rtsys2020/propendous/PROpendous/PROpendous_Layout.jpg

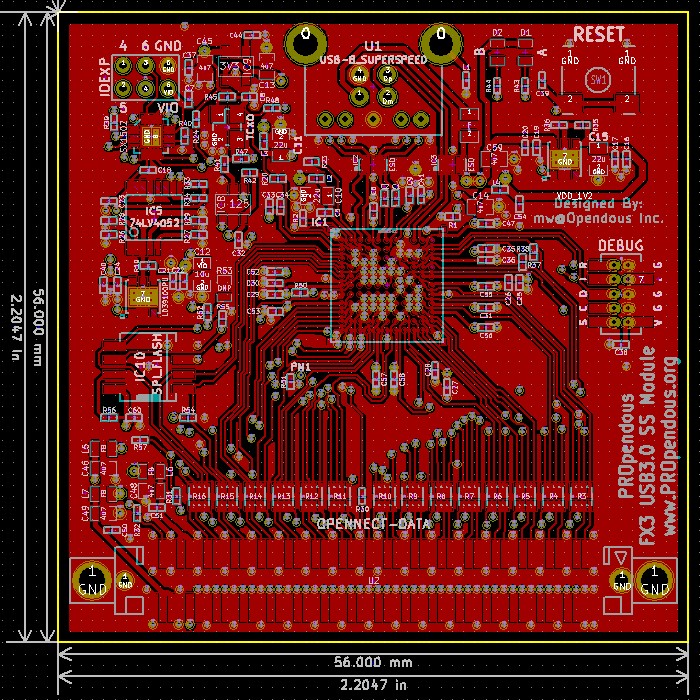
PROpendous/PROpendous_Layout.jpg
