rtsys2020/propendous/PROpendous/PROpendous-GERBERS/readme.txt

File Format: Gerber RS-274-X
Plot Origin: Absolute

	PROpendous-F_Paste.gtp		: Top/Front Layer Solder Paste

	PROpendous-F_SilkS.gto		: Top/Front Layer White Silkscreen
	PROpendous-F_Mask.gts		: Top/Front Layer Green Solder Mask
	PROpendous-F_Cu.gtl		: Top/Front Copper Layer
	PROpendous-Inner1_Cu.gbr	: Inner Copper Layer 1
	PROpendous-Inner2_Cu.gbr	: Inner Copper Layer 2
	PROpendous-B_Cu.gbl		: Bottom/Back Copper Layer
	PROpendous-B_Mask.gbs		: Bottom/Back Layer Green Solder Mask

	PROpendous-Edge_Cuts.gbr	: PCB Edge Outline

Drill File: RC_Audio.drl
	Excellon
	Units: Inches
	M.N (Precision) -> 2.4
	Mode (Drill Origin) : Absolute
	Zero Supression : Suppress Leading Zeros
	Type : ASCII
	Drill Holes (Pads and Vias): 472
	Notes:	- No axis mirroring
		- Standard Vias Only
		- All holes are plated
