rtsys2020/propendous/PROpendous/PROpendous.kicad_pcb

## KiCad design PROpendous/PROpendous.kicad_pcb (2013-10-24)

Schematic: PROpendous.sch, PROpendous FX3 Communication Board

Parts:
C46, C48, C49: 4u7
C50, C51: 0u1
IC1: CYUSB30XX-BZX
L5, L6, L7: FB
P2: PM1
R3, R4, R5, R6, R7, R8, R9, R10, R11, R12, R13, R14, R15, R16, R30, R31, R32: 22
R37, R38: 2.2k
R50, R51, R57: 10k
U2: OPENNECT-DATA

Connections:
26MHz: R32.2 (B); also elsewhere on the board
+3.3V: IC1.B6, L5.2 (B); also elsewhere on the board
+3.3V_BTB: C46.1 (A), L5.1 (A), U2.55 (3.3V)
/26MHz_BTB: R32.1 (A), U2.49 (26MHz)
/System/Dm: IC1.A10; also elsewhere on the board
/System/Dp: IC1.A9; also elsewhere on the board
/System/SSRXm: IC1.A3; also elsewhere on the board
/System/SSRXp: IC1.A4; also elsewhere on the board
/System/SSTXm: IC1.A6; also elsewhere on the board
/System/SSTXp: IC1.A5; also elsewhere on the board
AVDD: IC1.A7; also elsewhere on the board
CLKIN: IC1.D7; also elsewhere on the board
FSLC0: IC1.B2; also elsewhere on the board
FSLC1: IC1.B4; also elsewhere on the board
FSLC2: IC1.E6; also elsewhere on the board
GND: C46.2 (B), C48.2 (B), C49.2 (B), C50.2 (B), C51.2 (B), IC1.A1, IC1.A8, IC1.B7, IC1.B8, IC1.B9, IC1.D8, IC1.E2, IC1.G1, IC1.G11, IC1.K3, IC1.K4, IC1.L1, IC1.L2, IC1.L3, IC1.L6, IC1.L11, R51.1 (A), R57.1 (A), U2.1 (GND), U2.4 (GND), U2.7 (GND), U2.10 (GND), U2.13 (GND), U2.16 (GND), U2.19 (GND), U2.22 (GND), U2.25 (GND), U2.27 (GND), U2.30 (GND), U2.33 (GND), U2.36 (GND), U2.39 (GND), U2.42 (GND), U2.45 (GND), U2.48 (GND), U2.50 (GND), U2.51 (GND), U2.54 (GND), U2.57 (GND), U2.60 (GND), U2.63 (GND), U2.66 (GND), U2.69 (GND), U2.72 (GND), U2.75 (GND), U2.78 (GND), U2.81 (GND), U2.84 (GND), U2.87 (GND), U2.90 (GND), U2.93 (GND), U2.96 (GND), U2.99 (GND), U2.100 (GND); also elsewhere on the board
GPIO00: IC1.F10, R3.1
GPIO00-DQ00: R3.2, U2.2 (GPIO00-DQ00)
GPIO01: IC1.F9, R3.3
GPIO01-DQ01: R3.4, U2.3 (GPIO01-DQ01)
GPIO02: IC1.F7, R3.5
GPIO02-DQ02: R3.6, U2.98 (GPIO02-DQ02)
GPIO03: IC1.G10, R3.7
GPIO03-DQ03: R3.8, U2.97 (GPIO03-DQ03)
GPIO04: IC1.G9, R4.1
GPIO04-DQ04: R4.2, U2.5 (GPIO04-DQ04)
GPIO05: IC1.F8, R4.3
GPIO05-DQ05: R4.4, U2.6 (GPIO05-DQ05)
GPIO06: IC1.H10, R4.5
GPIO06-DQ06: R4.6, U2.95 (GPIO06-DQ06)
GPIO07: IC1.H9, R4.7
GPIO07-DQ07: R4.8, U2.94 (GPIO07-DQ07)
GPIO08: IC1.J10, R5.1
GPIO08-DQ08: R5.2, U2.8 (GPIO08-DQ08)
GPIO09: IC1.J9, R5.3
GPIO09-DQ09: R5.4, U2.9 (GPIO09-DQ09)
GPIO10: IC1.K11, R5.5
GPIO10-DQ10: R5.6, U2.92 (GPIO10-DQ10)
GPIO11: IC1.L10, R5.7
GPIO11-DQ11: R5.8, U2.91 (GPIO11-DQ11)
GPIO12: IC1.K10, R6.1
GPIO12-DQ12: R6.2, U2.11 (GPIO12-DQ12)
GPIO13: IC1.K9, R6.3
GPIO13-DQ13: R6.4, U2.12 (GPIO13-DQ13)
GPIO14: IC1.J8, R6.5
GPIO14-DQ14: R6.6, U2.89 (GPIO14-DQ14)
GPIO15: IC1.G8, R6.7
GPIO15-DQ15: R6.8, U2.88 (GPIO15-DQ15)
GPIO16: IC1.J6, R30.2 (B)
GPIO16-PCLK: R30.1 (A), U2.26 (GPIO16-PCLK)
GPIO17: IC1.K8, R11.1
GPIO17-CTL00: R11.2, U2.74 (GPIO17-CTL00)
GPIO18: IC1.K7, R11.3
GPIO18-CTL01: R11.4, U2.73 (GPIO18-CTL01)
GPIO19: IC1.J7, R11.5
GPIO19-CTL02: R11.6, U2.28 (GPIO19-CTL02)
GPIO20: IC1.H7, R11.7
GPIO20-CTL03: R11.8, U2.29 (GPIO20-CTL03)
GPIO21: IC1.G7, R12.1
GPIO21-CTL04: R12.2, U2.71 (GPIO21-CTL04)
GPIO22: IC1.G6, R12.3
GPIO22-CTL05: R12.4, U2.70 (GPIO22-CTL05)
GPIO23: IC1.K6, R12.5
GPIO23-CTL06: R12.6, U2.31 (GPIO23-CTL06)
GPIO24: IC1.H8, R12.7
GPIO24-CTL07: R12.8, U2.32 (GPIO24-CTL07)
GPIO25: IC1.G5, R13.1
GPIO25-CTL08: R13.2, U2.68 (GPIO25-CTL08)
GPIO26: IC1.H6, R13.3
GPIO26-CTL09: R13.4, U2.67 (GPIO26-CTL09)
GPIO27: IC1.K5, R13.5
GPIO27-CTL10: R13.6, U2.34 (GPIO27-CTL10)
GPIO28: IC1.J5, R13.7
GPIO28-CTL11: R13.8, U2.35 (GPIO28-CTL11)
GPIO29: IC1.H5, R14.1
GPIO29-CTL12: R14.2, U2.65 (GPIO29-CTL12)
GPIO30-PMODE0: IC1.G4, R50.1 (A)
GPIO31-PMODE1: IC1.H4, P2.1
GPIO32-PMODE2: IC1.L4, R51.2 (B)
GPIO33: IC1.K2, R7.1
GPIO33-DQ16: R7.2, U2.14 (GPIO33-DQ16)
GPIO34: IC1.J4, R7.3
GPIO34-DQ17: R7.4, U2.15 (GPIO34-DQ17)
GPIO35: IC1.K1, R7.5
GPIO35-DQ18: R7.6, U2.86 (GPIO35-DQ18)
GPIO36: IC1.J2, R7.7
GPIO36-DQ19: R7.8, U2.85 (GPIO36-DQ19)
GPIO37: IC1.J3, R8.1
GPIO37-DQ20: R8.2, U2.17 (GPIO37-DQ20)
GPIO38: IC1.J1, R8.3
GPIO38-DQ21: R8.4, U2.18 (GPIO38-DQ21)
GPIO39: IC1.H2, R8.5
GPIO39-DQ22: R8.6, U2.83 (GPIO39-DQ22)
GPIO40: IC1.H3, R8.7
GPIO40-DQ23: R8.8, U2.82 (GPIO40-DQ23)
GPIO41: IC1.F4, R9.1
GPIO41-DQ24: R9.2, U2.20 (GPIO41-DQ24)
GPIO42: IC1.G2, R9.3
GPIO42-DQ25: R9.4, U2.21 (GPIO42-DQ25)
GPIO43: IC1.G3, R9.5
GPIO43-DQ26: R9.6, U2.80 (GPIO43-DQ26)
GPIO44: IC1.F3, R9.7
GPIO44-DQ27: R9.8, U2.79 (GPIO44-DQ27)
GPIO45: IC1.F2, R31.2 (B), R57.2 (B)
GPIO45_BTB: R31.1 (A), U2.56 (GPIO45-nRESET)
GPIO46: IC1.F5, R10.1
GPIO46-DQ28: R10.2, U2.23 (GPIO46-DQ28)
GPIO47: IC1.E1, R10.3
GPIO47-DQ29: R10.4, U2.24 (GPIO47-DQ29)
GPIO48: IC1.E5, R10.5
GPIO48-DQ30: R10.6, U2.77 (GPIO48-DQ30)
GPIO49: IC1.E4, R10.7
GPIO49-DQ31: R10.8, U2.76 (GPIO49-DQ31)
GPIO50: IC1.D1, R14.5
GPIO50-I2S_CLK: R14.6, U2.37 (GPIO50-I2S_CLK)
GPIO51: IC1.D2, R14.7
GPIO51-I2S_SD: R14.8, U2.38 (GPIO51-I2S_SD)
GPIO52: IC1.D3, R15.1
GPIO52-I2S_WS: R15.2, U2.62 (GPIO52-I2S_WS)
GPIO53: IC1.D4, R15.7; also elsewhere on the board
GPIO53-UART_RTS-SPI_SCK: R15.8, U2.41 (UART_RTS-SPI_SCK)
GPIO54: IC1.C1, R15.5; also elsewhere on the board
GPIO54-UART_CTS-SPI_nSS: R15.6, U2.40 (UART_CTS-SPI_nSS)
GPIO55: IC1.C2, R16.1; also elsewhere on the board
GPIO55-UART_TX-SPI_MISO: R16.2, U2.59 (UART_TX-SPI_MISO)
GPIO56: IC1.D5, R16.3; also elsewhere on the board
GPIO56-UART_RX-SPI_MOSI: R16.4, U2.58 (UART_RX-SPI_MOSI)
GPIO57: IC1.C4, R15.3
GPIO57-I2S_MCLK: R15.4, U2.61 (GPIO57-I2S_MCLK)
GPIO58: IC1.D9, R16.5, R37.1 (A); also elsewhere on the board
GPIO58-I2C_SCL: R16.6, U2.43 (I2C_SCL)
GPIO59: IC1.D10, R16.7, R38.1 (A); also elsewhere on the board
GPIO59-I2C_SDA: R16.8, U2.44 (I2C_SDA)
R_USB2: IC1.C8; also elsewhere on the board
R_USB3: IC1.B3; also elsewhere on the board
TCK: IC1.F6; also elsewhere on the board
TDI: IC1.E7; also elsewhere on the board
TDO: IC1.C10; also elsewhere on the board
TMS: IC1.E8; also elsewhere on the board
U3RXVDDQ: IC1.A2; also elsewhere on the board
U3TXVDDQ: IC1.B5; also elsewhere on the board
VBUS: IC1.E10, IC1.E11, L7.2 (B); also elsewhere on the board
VBUS_BTB: C49.1 (A), C50.1 (A), L7.1 (A), U2.52 (5V), U2.53 (5V)
VDD_1V2: IC1.B10, IC1.C3, IC1.E9, IC1.F11, IC1.H1, IC1.J11, IC1.L5, IC1.L7; also elsewhere on the board
VIO: IC1.B1, IC1.C11, IC1.E3, IC1.F1, IC1.H11, IC1.L9, L6.2 (B), R37.2 (B), R38.2 (B), R50.2 (B); also elsewhere on the board
VIO_BTB: C48.1 (A), C51.1 (A), L6.1 (A), U2.46 (VIO), U2.47 (VIO)
nINT: IC1.L8, R14.3
nINT-CTL15: R14.4, U2.64 (nINT-CTL15)
nRESET: IC1.C5; also elsewhere on the board
nTRST: IC1.B11; also elsewhere on the board

Notes on the sheet:
IOs are tri-stated by default so allow 1.8V as the initial VIO supply voltage
26MHz clock signal is enabled via software It is off after reset
VIO defaults to 1.8V after reset or poweron
PMODE0 = 1 PMODE1 = F PMODE2 = 0 SPI Boot, On Failure, USB Boot is Enabled

Schematic: PROpendous-Power.sch, PROpendous FX3 Communication Board

Parts:
C5, C6, C17, C19, C21, C23, C25, C27, C29, C31, C33, C35, C37, C40, C41, C47, C52, C53, C54, C55, C56, C57, C58: 0u1
C9, C16, C20, C22, C24, C26, C28, C30, C34, C36, C44: u01
C10, C11, C15: 22u
C12: 10u
C13, C14, C45: 4u7
IC1: CYUSB30XX-BZX
IC4, IC6: LD39100PU
IC5: 74LV4052
IC9: 3V3
L2, L3, L4: FB
R19, R36: 47k
R26: 15k
R27: 22k
R28: 30k9
R29: 37k4
R33, R34: 10k
R35: 23k7

Connections:
+3.3V: C9.1 (A), C37.1 (A), C45.1 (A), IC1.B6, IC9.5 (OUT); also elsewhere on the board
/Power/1Y0: IC5.1 (2Y0), R26.2 (B)
/Power/1Y1: IC5.5 (2Y1), R27.2 (B)
/Power/1Y2: IC5.2 (2Y2), R28.2 (B)
/Power/1Y3: IC5.4 (2Y3), R29.2 (B)
/Power/VIO_ADJ: IC4.5 (ADJ), IC5.3 (2-COM), R19.1 (A)
/System/Dm: IC1.A10; also elsewhere on the board
/System/Dp: IC1.A9; also elsewhere on the board
/System/SSRXm: IC1.A3; also elsewhere on the board
/System/SSRXp: IC1.A4; also elsewhere on the board
/System/SSTXm: IC1.A6; also elsewhere on the board
/System/SSTXp: IC1.A5; also elsewhere on the board
AVDD: C14.1 (A), C41.1 (A), IC1.A7, L4.1 (A)
CLKIN: IC1.D7; also elsewhere on the board
FSLC0: IC1.B2; also elsewhere on the board
FSLC1: IC1.B4; also elsewhere on the board
FSLC2: IC1.E6; also elsewhere on the board
GND: C5.2 (B), C6.2 (B), C9.2 (B), C10.2 (B), C11.2 (B), C12.2 (B), C13.2 (B), C14.2 (B), C15.2 (B), C16.2 (B), C17.2 (B), C19.2 (B), C20.2 (B), C21.2 (B), C22.2 (B), C23.2 (B), C24.2 (B), C25.2 (B), C26.2 (B), C27.2 (B), C28.2 (B), C29.2 (B), C30.2 (B), C31.2 (B), C33.2 (B), C34.2 (B), C35.2 (B), C36.2 (B), C37.2 (B), C40.2 (B), C41.2 (B), C44.2 (B), C45.2 (B), C47.2 (B), C52.2 (B), C53.2 (B), C54.2 (B), C55.2 (B), C56.2 (B), C57.2 (B), C58.2 (B), IC1.A1, IC1.A8, IC1.B7, IC1.B8, IC1.B9, IC1.D8, IC1.E2, IC1.G1, IC1.G11, IC1.K3, IC1.K4, IC1.L1, IC1.L2, IC1.L3, IC1.L6, IC1.L11, IC4.2 (GND), IC4.7 (GND-PAD), IC5.6 (nE), IC5.7 (VEE), IC5.8 (GND), IC5.13 (1-COM), IC6.2 (GND), IC6.7 (GND-PAD), IC9.2 (GND), R26.1 (A), R27.1 (A), R28.1 (A), R29.1 (A), R36.1 (A); also elsewhere on the board
GPIO00: IC1.F10; also elsewhere on the board
GPIO01: IC1.F9; also elsewhere on the board
GPIO02: IC1.F7; also elsewhere on the board
GPIO03: IC1.G10; also elsewhere on the board
GPIO04: IC1.G9; also elsewhere on the board
GPIO05: IC1.F8; also elsewhere on the board
GPIO06: IC1.H10; also elsewhere on the board
GPIO07: IC1.H9; also elsewhere on the board
GPIO08: IC1.J10; also elsewhere on the board
GPIO09: IC1.J9; also elsewhere on the board
GPIO10: IC1.K11; also elsewhere on the board
GPIO11: IC1.L10; also elsewhere on the board
GPIO12: IC1.K10; also elsewhere on the board
GPIO13: IC1.K9; also elsewhere on the board
GPIO14: IC1.J8; also elsewhere on the board
GPIO15: IC1.G8; also elsewhere on the board
GPIO16: IC1.J6; also elsewhere on the board
GPIO17: IC1.K8; also elsewhere on the board
GPIO18: IC1.K7; also elsewhere on the board
GPIO19: IC1.J7; also elsewhere on the board
GPIO20: IC1.H7; also elsewhere on the board
GPIO21: IC1.G7; also elsewhere on the board
GPIO22: IC1.G6; also elsewhere on the board
GPIO23: IC1.K6; also elsewhere on the board
GPIO24: IC1.H8; also elsewhere on the board
GPIO25: IC1.G5; also elsewhere on the board
GPIO26: IC1.H6; also elsewhere on the board
GPIO27: IC1.K5; also elsewhere on the board
GPIO28: IC1.J5; also elsewhere on the board
GPIO29: IC1.H5; also elsewhere on the board
GPIO30-PMODE0: IC1.G4; also elsewhere on the board
GPIO31-PMODE1: IC1.H4; also elsewhere on the board
GPIO32-PMODE2: IC1.L4; also elsewhere on the board
GPIO33: IC1.K2; also elsewhere on the board
GPIO34: IC1.J4; also elsewhere on the board
GPIO35: IC1.K1; also elsewhere on the board
GPIO36: IC1.J2; also elsewhere on the board
GPIO37: IC1.J3; also elsewhere on the board
GPIO38: IC1.J1; also elsewhere on the board
GPIO39: IC1.H2; also elsewhere on the board
GPIO40: IC1.H3; also elsewhere on the board
GPIO41: IC1.F4; also elsewhere on the board
GPIO42: IC1.G2; also elsewhere on the board
GPIO43: IC1.G3; also elsewhere on the board
GPIO44: IC1.F3; also elsewhere on the board
GPIO45: IC1.F2; also elsewhere on the board
GPIO46: IC1.F5; also elsewhere on the board
GPIO47: IC1.E1; also elsewhere on the board
GPIO48: IC1.E5; also elsewhere on the board
GPIO49: IC1.E4; also elsewhere on the board
GPIO50: IC1.D1; also elsewhere on the board
GPIO51: IC1.D2; also elsewhere on the board
GPIO52: IC1.D3; also elsewhere on the board
GPIO53: IC1.D4; also elsewhere on the board
GPIO54: IC1.C1; also elsewhere on the board
GPIO55: IC1.C2; also elsewhere on the board
GPIO56: IC1.D5; also elsewhere on the board
GPIO57: IC1.C4; also elsewhere on the board
GPIO58: IC1.D9; also elsewhere on the board
GPIO59: IC1.D10; also elsewhere on the board
IOEXP0: IC5.10 (S0), R34.1 (A); also elsewhere on the board
IOEXP1: IC5.9 (S1), R33.1 (A); also elsewhere on the board
unnamed: IC6.5 (ADJ), R35.1 (A), R36.2 (B)
unnamed: C44.1 (A), IC9.4 (NR)
R_USB2: IC1.C8; also elsewhere on the board
R_USB3: IC1.B3; also elsewhere on the board
TCK: IC1.F6; also elsewhere on the board
TDI: IC1.E7; also elsewhere on the board
TDO: IC1.C10; also elsewhere on the board
TMS: IC1.E8; also elsewhere on the board
U3RXVDDQ: C5.1 (A), C10.1 (A), IC1.A2, L2.1 (A)
U3TXVDDQ: C6.1 (A), C11.1 (A), IC1.B5, L3.1 (A)
VBUS: C13.1 (A), C19.1 (A), C20.1 (A), C23.1 (A), C24.1 (A), C25.1 (A), C26.1 (A), C40.1 (A), IC1.E10, IC1.E11, IC4.1 (EN), IC4.6 (VI), IC5.16 (VCC), IC6.1 (EN), IC6.6 (VI), IC9.1 (IN), IC9.3 (EN), R33.2 (B), R34.2 (B); also elsewhere on the board
VDD_1V2: C15.1 (A), C16.1 (A), C17.1 (A), C47.1 (A), C52.1 (A), C53.1 (A), C54.1 (A), C55.1 (A), C56.1 (A), C57.1 (A), C58.1 (A), IC1.B10, IC1.C3, IC1.E9, IC1.F11, IC1.H1, IC1.J11, IC1.L5, IC1.L7, IC6.4 (VO), L2.2 (B), L3.2 (B), L4.2 (B), R35.2 (B)
VIO: C12.1 (A), C21.1 (A), C22.1 (A), C27.1 (A), C28.1 (A), C29.1 (A), C30.1 (A), C31.1 (A), C33.1 (A), C34.1 (A), C35.1 (A), C36.1 (A), IC1.B1, IC1.C11, IC1.E3, IC1.F1, IC1.H11, IC1.L9, IC4.4 (VO), R19.2 (B); also elsewhere on the board
nINT: IC1.L8; also elsewhere on the board
nRESET: IC1.C5; also elsewhere on the board
nTRST: IC1.B11; also elsewhere on the board

Notes on the sheet:
3.31V = 0.8V(1 + (47k/15k))
2.02V = 0.8V(1 + (47k/30.9k))
2.51V = 0.8V(1 + (47k/22k))
1.81V = 0.8V(1 + (47k/37.4k))
Default to S0=H, S1=H for 1.8V VIO at startup
1.2V=0.8V(1+(23.7k/47k))
VIO
1.2V
VBATT
CVDDQ
VIO1
VIO2
VIO3
VIO4
VIO5
CVDDQ can range between 1.8V to 3.3V for compatibility with various oscillators

Schematic: PROpendous-System.sch, PROpendous FX3 Communication Board

Parts:
C1, C2, C7, C8, C18, C32, C38, C39, C60: 0u1
C59: 4u7
D1: A
D2: B
F1: F
IC1: CYUSB30XX-BZX
IC2, IC3: ESD
IC7: SX1502
IC8: 125
IC10: SPI_FLASH
L1: FB
P1: IOEXP
R1: 6.04k
R2: 200
R20, R23, R24, R39, R40, R42, R45, R48, R52, R54, R56: 10k
R41, R47: 22
R43, R44: 1k
R53: DNP
R55: 100k
SW1: RESET
U1: USB-B_SUPERSPEED
U3: DEBUG
V1, V2, V3, V4: VIA
X1: TCXO

Connections:
26MHz: IC8.4 (Y); also elsewhere on the board
+3.3V: C8.1 (A), IC1.B6, R20.2 (B), R24.2 (B), R45.2 (B), R48.2 (B), X1.4 (VDD); also elsewhere on the board
/System/125_A: IC8.2 (A), R41.2 (B)
/System/Dm: IC1.A10, IC3.2 (ESD), IC3.9 (NC), U1.2 (Dm)
/System/Dp: IC1.A9, IC3.1 (ESD), IC3.10 (NC), U1.3 (Dp)
/System/IOEXP_nRESET: IC7.1 (nRESET), R39.1 (A)
/System/SSRXm: IC1.A3, IC2.1 (ESD), IC2.10 (NC), U1.8 (SSRXm), V1.1
/System/SSRXp: IC1.A4, IC2.2 (ESD), IC2.9 (NC), U1.9 (SSRXp), V2.1
/System/SSTXm: C1.1 (A), IC1.A6
/System/SSTXm_AC: C1.2 (B), IC2.5 (ESD), IC2.6 (NC), U1.5 (SSTXm), V3.1
/System/SSTXp: C2.1 (A), IC1.A5
/System/SSTXp_AC: C2.2 (B), IC2.4 (ESD), IC2.7 (NC), U1.6 (SSTXp), V4.1
/System/TCXO_EN: R45.1 (A), X1.1 (EN)
/System/TCXO_OUT: R41.1 (A), R47.1 (A), X1.3 (OUT)
/System/VBUS_F: F1.1 (A), U1.1 (VBUS)
AVDD: IC1.A7; also elsewhere on the board
CLKIN: IC1.D7, R47.2 (B)
FSLC0: IC1.B2, R20.1 (A)
FSLC1: IC1.B4, R23.2 (B)
FSLC2: IC1.E6, R24.1 (A)
GND: C7.2 (B), C8.2 (B), C18.2 (B), C32.2 (B), C38.2 (B), C39.2 (B), C59.2 (B), C60.2 (B), IC1.A1, IC1.A8, IC1.B7, IC1.B8, IC1.B9, IC1.D8, IC1.E2, IC1.G1, IC1.G11, IC1.K3, IC1.K4, IC1.L1, IC1.L2, IC1.L3, IC1.L6, IC1.L11, IC2.3 (GND), IC2.8 (GND), IC3.3 (GND), IC3.8 (GND), IC7.8 (GND), IC7.18 (GND), IC8.3 (GND), IC10.4 (GND), L1.1 (A), P1.5, R1.1 (A), R2.1 (A), R23.1 (A), R53.1 (A), R55.1 (A), SW1.1 (A), U1.4 (GND), U1.7 (GND_DRAIN), U3.3 (GND), U3.5 (GND), U3.9 (GND), X1.2 (GND); also elsewhere on the board
GNDSHIELD: L1.2 (B), U1.0 (SHIELD)
GPIO00: IC1.F10; also elsewhere on the board
GPIO01: IC1.F9; also elsewhere on the board
GPIO02: IC1.F7; also elsewhere on the board
GPIO03: IC1.G10; also elsewhere on the board
GPIO04: IC1.G9; also elsewhere on the board
GPIO05: IC1.F8; also elsewhere on the board
GPIO06: IC1.H10; also elsewhere on the board
GPIO07: IC1.H9; also elsewhere on the board
GPIO08: IC1.J10; also elsewhere on the board
GPIO09: IC1.J9; also elsewhere on the board
GPIO10: IC1.K11; also elsewhere on the board
GPIO11: IC1.L10; also elsewhere on the board
GPIO12: IC1.K10; also elsewhere on the board
GPIO13: IC1.K9; also elsewhere on the board
GPIO14: IC1.J8; also elsewhere on the board
GPIO15: IC1.G8; also elsewhere on the board
GPIO16: IC1.J6; also elsewhere on the board
GPIO17: IC1.K8; also elsewhere on the board
GPIO18: IC1.K7; also elsewhere on the board
GPIO19: IC1.J7; also elsewhere on the board
GPIO20: IC1.H7; also elsewhere on the board
GPIO21: IC1.G7; also elsewhere on the board
GPIO22: IC1.G6; also elsewhere on the board
GPIO23: IC1.K6; also elsewhere on the board
GPIO24: IC1.H8; also elsewhere on the board
GPIO25: IC1.G5; also elsewhere on the board
GPIO26: IC1.H6; also elsewhere on the board
GPIO27: IC1.K5; also elsewhere on the board
GPIO28: IC1.J5; also elsewhere on the board
GPIO29: IC1.H5; also elsewhere on the board
GPIO30-PMODE0: IC1.G4; also elsewhere on the board
GPIO31-PMODE1: IC1.H4; also elsewhere on the board
GPIO32-PMODE2: IC1.L4; also elsewhere on the board
GPIO33: IC1.K2; also elsewhere on the board
GPIO34: IC1.J4; also elsewhere on the board
GPIO35: IC1.K1; also elsewhere on the board
GPIO36: IC1.J2; also elsewhere on the board
GPIO37: IC1.J3; also elsewhere on the board
GPIO38: IC1.J1; also elsewhere on the board
GPIO39: IC1.H2; also elsewhere on the board
GPIO40: IC1.H3; also elsewhere on the board
GPIO41: IC1.F4; also elsewhere on the board
GPIO42: IC1.G2; also elsewhere on the board
GPIO43: IC1.G3; also elsewhere on the board
GPIO44: IC1.F3; also elsewhere on the board
GPIO45: IC1.F2; also elsewhere on the board
GPIO46: IC1.F5; also elsewhere on the board
GPIO47: IC1.E1; also elsewhere on the board
GPIO48: IC1.E5; also elsewhere on the board
GPIO49: IC1.E4; also elsewhere on the board
GPIO50: IC1.D1; also elsewhere on the board
GPIO51: IC1.D2; also elsewhere on the board
GPIO52: IC1.D3; also elsewhere on the board
GPIO53: IC1.D4, IC10.6 (CLK), R55.2 (B); also elsewhere on the board
GPIO54: IC1.C1, IC10.1 (nCS), R54.1 (A); also elsewhere on the board
GPIO55: IC1.C2, IC10.2 (DO/IO1); also elsewhere on the board
GPIO56: IC1.D5, IC10.5 (DI/IO0); also elsewhere on the board
GPIO57: IC1.C4; also elsewhere on the board
GPIO58: IC1.D9, IC7.4 (SCL); also elsewhere on the board
GPIO59: IC1.D10, IC7.2 (SDA); also elsewhere on the board
IOEXP0: IC7.5 (IO0); also elsewhere on the board
IOEXP1: IC7.6 (IO1); also elsewhere on the board
IOEXP2: IC7.9 (IO2), R43.1 (A)
IOEXP3: IC7.10 (IO3), R44.1 (A)
IOEXP4: IC7.15 (IO4), P1.1
IOEXP5: IC7.16 (IO5), P1.2
IOEXP6: IC7.19 (IO6), P1.3
IOEXP7: IC7.20 (IO7), IC8.1 (nOE), R42.1 (A)
unnamed: D2.1 (K), R44.2 (B)
unnamed: D1.1 (K), R43.2 (B)
unnamed: IC7.12 (ADDR), R40.1 (A)
unnamed: IC10.7 (nHOLD/IO3), R56.1 (A)
unnamed: IC3.4 (ESD), IC3.7 (NC)
R_USB2: IC1.C8, R1.2 (B)
R_USB3: IC1.B3, R2.2 (B)
SPI_nWP: IC10.3 (nWP/IO2), R52.1 (A), R53.2 (B)
TCK: IC1.F6, U3.4 (TCK)
TDI: IC1.E7, U3.8 (TDI)
TDO: IC1.C10, U3.6 (TDO)
TMS: IC1.E8, U3.2 (TMS)
U3RXVDDQ: IC1.A2; also elsewhere on the board
U3TXVDDQ: IC1.B5; also elsewhere on the board
VBUS: C18.1 (A), C59.1 (A), D1.2 (A), D2.2 (A), F1.2 (B), IC1.E10, IC1.E11, IC3.5 (ESD), IC3.6 (NC), IC7.7 (VCC1); also elsewhere on the board
VDD_1V2: IC1.B10, IC1.C3, IC1.E9, IC1.F11, IC1.H1, IC1.J11, IC1.L5, IC1.L7; also elsewhere on the board
VIO: C7.1 (A), C32.1 (A), C38.1 (A), C60.1 (A), IC1.B1, IC1.C11, IC1.E3, IC1.F1, IC1.H11, IC1.L9, IC7.14 (VDDM), IC7.17 (VCC2), IC8.5 (VCC), IC10.8 (VCC), P1.6, R39.2 (B), R40.2 (B), R42.2 (B), R52.2 (B), R54.2 (B), R56.2 (B), U3.1 (VDD); also elsewhere on the board
nINT: IC1.L8; also elsewhere on the board
nRESET: C39.1 (A), IC1.C5, R48.1 (A), SW1.2 (B)
nTRST: IC1.B11, U3.10 (nRST)

Notes on the sheet:
Use 26MHz clock FSLC0 = 1 FSLC1 = 0 FSLC2 = 1
JTAG powered by VIO JTAG pins have internal pull up or down resistors
TPD4EUSB30DQA TPD4E05U06DQA ESD7004MUTAG SP0524PUTG CDDFN10-0524P ESDLC5V0DFN10
ASTX-H11-26.000MHZ-T
PTC use
CVDDQ=3.3V in Power
74LVC1G
Support Circuitry GPIO
Uses FX3 I2C I2C Address = (0100001rw) = 0x21 = 33
Oscillator
USB
IOEXP7 enables clock on BTB conn
IOEXP0, IOEXP1 select VIO voltage
I2C_SCL
I2C_SDA
Clock Buffer for BTB Conn
SPI_nSS
SPI_MISO
SPI_CLK
SPI_MOSI
SPI Configuration
Allow In-System Programming nWP = H
There is unfortunately no 1.8V-3.3V SPI FLASH

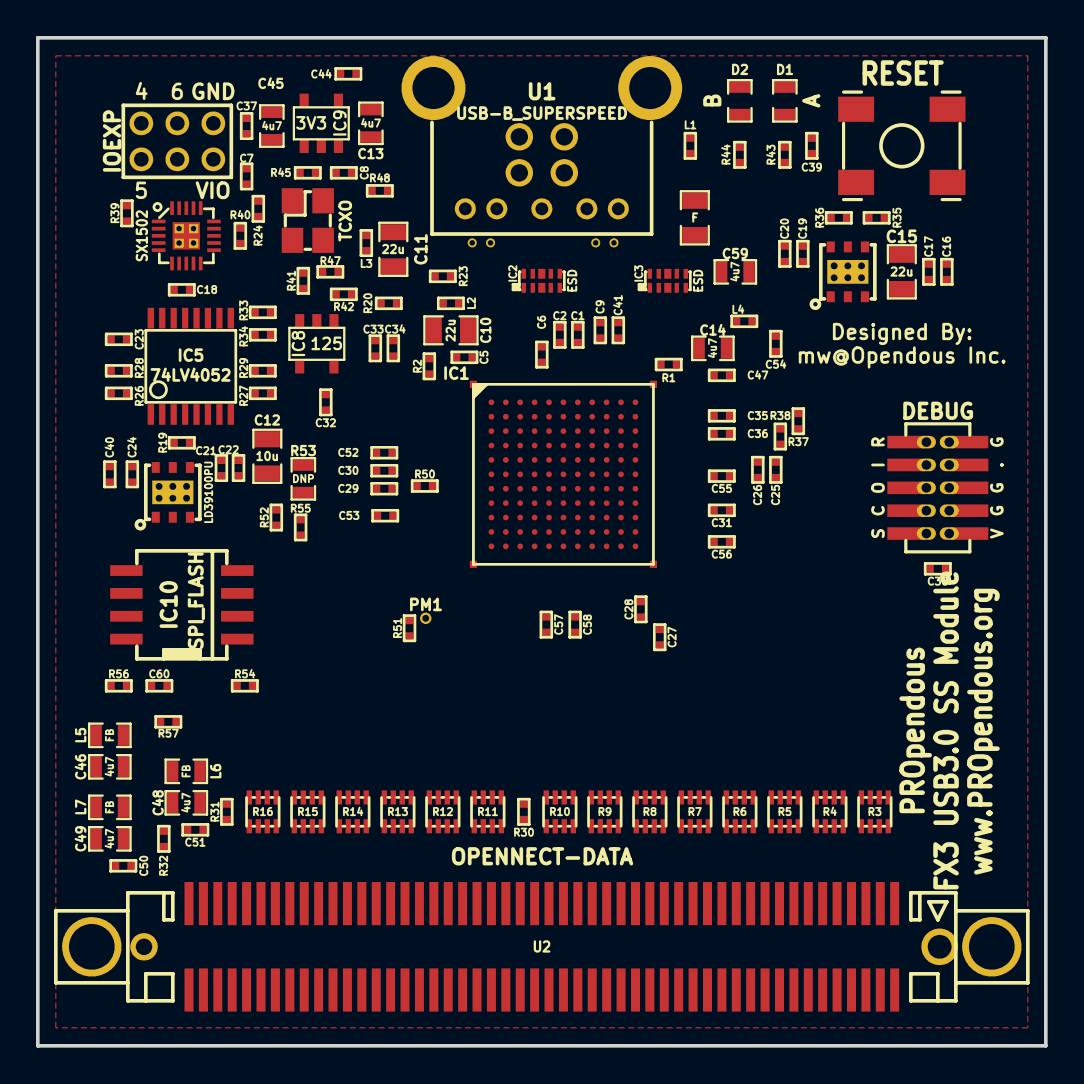
[picture p2: board PROpendous.kicad_pcb from above]

Board: 4 copper layers, 56.0 x 56.0 mm, 137 parts (0 on the bottom side), 179 nets, no tracks yet.
