rtsys2020/propendous/(commit log)

2010-02-06 Added PRopendous-DIY hardware design files.
    [PROpendous-DIY-Connectors_JTAG.sch, PROpendous-DIY-LPC313x.sch, PROpendous-DIY-Memory.sch, PROpendous-DIY-Power.sch, PROpendous-DIY-Vias.sch, PROpendous-DIY.brd, PROpendous-DIY.sch]
2010-04-06 Started PRopendous iMX233-based design.
    [Propendous-Connectors_JTAG.sch, Propendous-Memory.sch, Propendous-Power.sch, Propendous-Vias.sch, Propendous-iMX233.sch, Propendous.sch]
2010-04-08 Renamed files.
    [PROpendous-Connectors_JTAG.sch, PROpendous-Memory.sch, PROpendous-Power.sch, PROpendous-Vias.sch, PROpendous-iMX233.sch, PROpendous.sch]
2010-04-08 Updated files. DDR SDRAM schematic completed.
    [PROpendous-Connectors_JTAG.sch, PROpendous-Memory.sch, PROpendous-Power.sch, PROpendous-Vias.sch, PROpendous-iMX233.sch, PROpendous.brd, PROpendous.sch]
2010-04-17 Updated PROpendous i.MX233 project. DDR SDRAM layout is complete.
    [PROpendous-Connectors_JTAG.sch, PROpendous-LCD.sch, PROpendous-Memory.sch, PROpendous-Power.sch, PROpendous-Vias.sch, PROpendous-iMX233.sch, PROpendous.brd, PROpendous.sch]
2010-04-20 Updated PROpendous project. Schematic is complete but not yet finalized. Layout partially complete.
    [PROpendous-Audio.sch, PROpendous-Connectors_JTAG.sch, PROpendous-LCD.sch, PROpendous-Memory.sch, PROpendous-Power.sch, PROpendous-Power_Boot.sch, PROpendous-Vias.sch, PROpendous-iMX233.sch]
2010-04-22 Minor update to schematic. Removed USB Power switch and added some notes.
    [PROpendous-Connectors_JTAG.sch, PROpendous-LCD.sch, PROpendous-Memory.sch, PROpendous-Power_Boot.sch, PROpendous-Vias.sch, PROpendous-iMX233.sch, PROpendous.brd, PROpendous.sch]
2010-04-24 Updated PROpendous Project. PCB layout is nearing completion.
    [PROpendous-Audio.sch, PROpendous-Connectors_JTAG.sch, PROpendous-LCD.sch, PROpendous-Memory.sch, PROpendous-Power_Boot.sch, PROpendous-Vias.sch, PROpendous-iMX233.sch, PROpendous.brd]
2010-04-25 Updated layout.
    [PROpendous-Audio.sch, PROpendous-Connectors_JTAG.sch, PROpendous-LCD.sch, PROpendous-Memory.sch, PROpendous-Power_Boot.sch, PROpendous-Vias.sch, PROpendous-iMX233.sch, PROpendous.brd]
2010-04-25 Updated layout. Extended expansion connector and moved microSD.
    [PROpendous-Audio.sch, PROpendous-Connectors_JTAG.sch, PROpendous-LCD.sch, PROpendous-Memory.sch, PROpendous-Power_Boot.sch, PROpendous-Vias.sch, PROpendous-iMX233.sch, PROpendous.brd]
2010-04-26 First revision of i.MX233-based PROpendous board is complete.
    [PROpendous-Audio.sch, PROpendous-Connectors_JTAG.sch, PROpendous-LCD.sch, PROpendous-Memory.sch, PROpendous-Power_Boot.sch, PROpendous-Vias.sch, PROpendous-iMX233.sch, PROpendous.brd]
2010-04-27 Updated i.MX233-based PROpendous board with EEPROM to fix Freescale Errata #2229.
    [PROpendous-Audio.sch, PROpendous-Connectors_JTAG.sch, PROpendous-LCD.sch, PROpendous-Memory.sch, PROpendous-Power_Boot.sch, PROpendous-Vias.sch, PROpendous-iMX233.sch, PROpendous.brd]
2010-05-06 Added Gerber PCB manufacturing files. Started Bill Of Materials.
    [PROpendous.brd]
2010-05-06 Update Bill of Materials.
2010-05-06 Completed Bill of Materials.
2010-05-18 Updated design files. Added picture of finished PCB.
    [PROpendous-Audio.sch, PROpendous-Connectors_JTAG.sch, PROpendous-LCD.sch, PROpendous-Memory.sch, PROpendous-Power_Boot.sch, PROpendous-Vias.sch, PROpendous-iMX233.sch, PROpendous.brd]
2010-05-18 Added PROpendous assembly instructions.
2010-05-18 Updated PROpendous design and manufacturing files.
    [PROpendous-Audio.sch, PROpendous-Connectors_JTAG.sch, PROpendous-LCD.sch, PROpendous-Memory.sch, PROpendous-Power_Boot.sch, PROpendous-Vias.sch, PROpendous-iMX233.sch, PROpendous.brd]
2010-05-31 Updated PROpendous design with correct FSUSB20 footprint. Added pictures of minimally assembled board and related testing.
    [PROpendous-Audio.sch, PROpendous-Connectors_JTAG.sch, PROpendous-LCD.sch, PROpendous-Memory.sch, PROpendous-Power_Boot.sch, PROpendous-Vias.sch, PROpendous-iMX233.sch, PROpendous.brd]
2010-06-05 Updated PROpendous Manufacturing Gerbers to the latest revision.
    [PROpendous.brd]
2010-06-07 Updated PROpendous with correct I2C EEPROM address. Added pictures of the LPC3130 based PROpendous-DIY.
    [PROpendous-Audio.sch, PROpendous-Connectors_JTAG.sch, PROpendous-LCD.sch, PROpendous-Memory.sch, PROpendous-Power_Boot.sch, PROpendous-Vias.sch, PROpendous-iMX233.sch, PROpendous.brd]
2010-06-21 Switch to ceramic capacitors for bulk decoupling which are less expensive than similarly low-ESR tantalum capacitors.
    [PROpendous-Audio.sch, PROpendous-Connectors_JTAG.sch, PROpendous-LCD.sch, PROpendous-Memory.sch, PROpendous-Power_Boot.sch, PROpendous-Vias.sch, PROpendous-iMX233.sch, PROpendous.brd]
2010-06-21 Updated Gerber fabrication files to latest revision.
2010-09-28 Updated the design. JTAG header now includes VDD_XTAL and SSP1_Detect. 1.8" LCD has been removed and LCD backlight control is now connected to GPMI_CE1n. The clock signals for the DDR SDRAM are now t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
    [PROpendous-Audio.sch, PROpendous-Connectors_JTAG.sch, PROpendous-LCD.sch, PROpendous-Memory.sch, PROpendous-Power_Boot.sch, PROpendous-Vias.sch, PROpendous-iMX233.sch, PROpendous.brd]
2010-10-12 Removed LPC313x version of the PROpendous. Focus has for a while been on the i.MX233 version. LPC313x design is now available at: http://code.google.com/p/opendous/source/browse/trunk/Abandoned_Desig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
    [PROpendous-DIY-Connectors_JTAG.sch, PROpendous-DIY-LPC313x.sch, PROpendous-DIY-Memory.sch, PROpendous-DIY-Power.sch, PROpendous-DIY-Vias.sch, PROpendous-DIY.brd, PROpendous-DIY.sch]
2010-10-13 Replaced 3M 2908-05WB-MG microSD connector with the better stocked Amphenol 101-00303-68.
    [PROpendous-Audio.sch, PROpendous-Connectors_JTAG.sch, PROpendous-LCD.sch, PROpendous-Memory.sch, PROpendous-Power_Boot.sch, PROpendous-Vias.sch, PROpendous-iMX233.sch, PROpendous.brd]
2010-10-13 Updated Bill of Materials with new microSD connector.
2010-10-20 Updated PROpendous design with minor correction to silkscreen and two more bypass capacitors for the microSD connector. Also added Buttons Module design files.
    [PROpendous-Audio.sch, PROpendous-Connectors_JTAG.sch, PROpendous-LCD.sch, PROpendous-Memory.sch, PROpendous-Power_Boot.sch, PROpendous-Vias.sch, PROpendous-iMX233.sch, PROpendous.brd]
2010-10-21 Updated PROpendous design. PWM2-GPMI_RDY3 now controls the LCD backlight and GPMI_CE1n now controls USB Host enable. The function of these pins was switched as PWM2 makes more sense as a backlight co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
    [PROpendous-Audio.sch, PROpendous-Connectors_JTAG.sch, PROpendous-LCD.sch, PROpendous-Memory.sch, PROpendous-Power_Boot.sch, PROpendous-Vias.sch, PROpendous-iMX233.sch, PROpendous.brd]
2010-10-31 Minor update of Connectors_JTAG sheet with note about updated microSD connector part number.
    [PROpendous-Connectors_JTAG.sch]
2010-11-18 Added pictures of a fully assembled board.
2012-10-03 Minor directory renaming and removed individual schematic PDFs.
    [PROpendous-Audio.sch, PROpendous-Connectors_JTAG.sch, PROpendous-LCD.sch, PROpendous-Memory.sch, PROpendous-Power_Boot.sch, PROpendous-Vias.sch, PROpendous-iMX233.sch, PROpendous.brd]
2012-10-03 Updated all design files with CC0 Public Domain License. Added single PDF version of schematic. Updated the layout's GND fill to solid instead of thermal. Kept previous revision Gerbers.
    [PROpendous-Audio.sch, PROpendous-Connectors_JTAG.sch, PROpendous-LCD.sch, PROpendous-Memory.sch, PROpendous-Power_Boot.sch, PROpendous-Vias.sch, PROpendous-iMX233.sch, PROpendous.brd]
2013-10-24 Removed i.MX233 Project Files.
    [PROpendous-Audio.sch, PROpendous-Connectors_JTAG.sch, PROpendous-LCD.sch, PROpendous-Memory.sch, PROpendous-Power_Boot.sch, PROpendous-Vias.sch, PROpendous-iMX233.sch, PROpendous.brd]
2013-10-24 Added PROpendous FX3 ( CYUSB301x-BZX) USB3.0 SuperSpeed Module project files.
    [PROpendous-Power.sch, PROpendous-System.sch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]
