rtsys2020/propendous/(notices)

Notices in the files:
PROpendous/PROpendous-System.sch:
Opendous Inc. deeded this hardware design into the Public Domain
http://creativecommons.org/publicdomain/zero/1.0
No Copyright - Deeded under the Creative Commons CC0 Public Domain Dedication
